WullT/MultisensorLoRaNode/(commit log)

2022-01-22 add sample configuration
2022-01-22 add abp/otaa sample config files
2022-01-27 add wiring image
2022-01-27 add negative temperatures support
